AlexandreAbreuCzr/HaraTech/(commit log)

2026-07-07 Corrige PUMP_ACTIVE_HIGH para false (relé comum é active LOW) e adiciona exibição de umidade no site
    [initial.ino]
2026-07-09 refactor: redesign completo da interface Hara Tech
    - Redesign completo do frontend com tema claro/escuro (nature-inspired)
    - Paleta verde como cor primária, tons neutros suaves
    - Tema com CSS variables + ThemeProvider
    - Componentes de UI compartilhados (Button, Card, Input, Modal, Badge, etc)
    - Layout redesenhado com sidebar elegante e header clean
    - Login/Register com painel visual
    - Dashboard com cards de métricas e barras de umidade
    - DeviceDetail com telemetria ao vivo e controles
    - Páginas redesenhadas (Devices, Plants, Schedules, History)
    - Micro-animações (fade, slide-up, scale-in)
    - Estados de loading (skeleton), empty e error
    - Scrollbar customizada e transições suaves
    - Corr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
    [initial.ino]
2026-07-26 feat: stabilize irrigation control and dashboard
    [initial.ino]
2026-08-27 fix: make manual watering pump commands deterministic
2026-08-30 feat: add public landing page and SEO foundation
2026-08-31 feat: align irrigation with three fixed outputs
    [initial.ino]
2026-08-31 fix: reduce irrigation command latency
    [initial.ino]
2026-09-01 docs: add complete Hara Tech wiring diagram
2026-09-01 fix: use GPIO 32 for third soil sensor
    [initial.ino]
2026-09-01 fix: prevent replayed irrigation commands
    [initial.ino]
2026-09-02 fix: restore areas after device restart
    [initial.ino]
2026-09-02 fix: stabilize area restore and sensor readings
    [initial.ino]
2026-09-02 fix: detect disconnected soil sensors
    [initial.ino]
